iAmArsta/Propeller-v-thrust/README.md

# Propeller-v-thrust
The setup for my IB Physics IA, investigating the effect of propeller blade pitch on thrust.
Code and 3d files have been uploaded.

Parts list:
ESP32 doit devkit
5kg load cell
HX711 module
Any infrared sensor
1400kv 2212 brushless motor
30 Amp ESC
