iAmArsta/Propeller-v-thrust/STLs/physicProjmotorMount_PLA_25m55s.stl

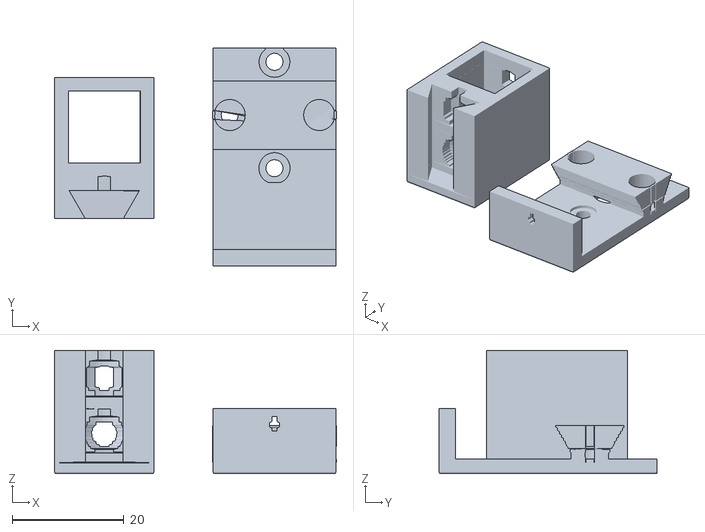
[picture p7: CAD file, 2026-11-01]
STLs/physicProjmotorMount_PLA_25m55s.stl
50.4 x 39.0 x 22.0
