iAmArsta/Propeller-v-thrust/STLs/Prop_130mm_10deg_v2_PETG_1h52m.stl

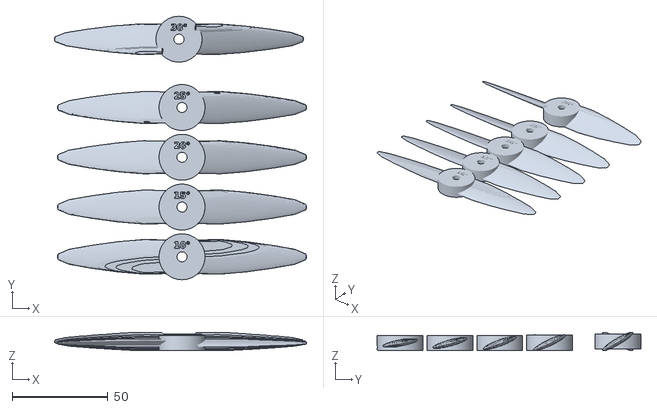
[picture p8: CAD file, 2026-11-01]
STLs/Prop_130mm_10deg_v2_PETG_1h52m.stl
131.6 x 137.7 x 9.60
