iAmArsta/Propeller-v-thrust/STLs/physProj_PLA_1h11m.stl

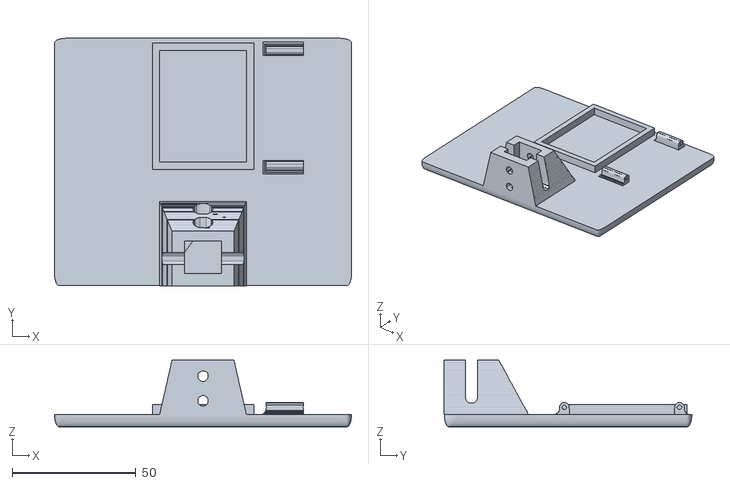
[picture p9: CAD file, 2026-11-01]
STLs/physProj_PLA_1h11m.stl
119.9 x 99.9 x 27.0
