iAmArsta/Propeller-v-thrust/STLs/physicProjmotorMount13_PLA_15m30s.stl

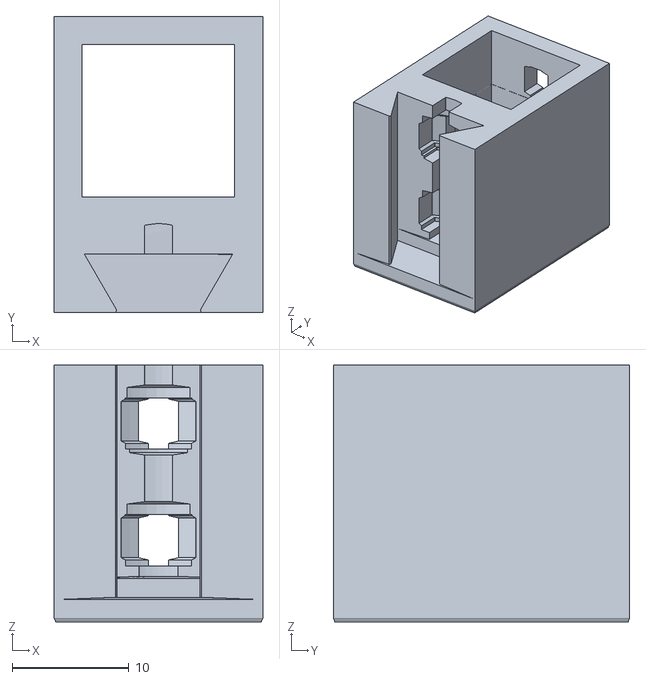
[picture p10: CAD file, 2026-11-01]
STLs/physicProjmotorMount13_PLA_15m30s.stl
17.9 x 25.4 x 22.0
