iAmArsta/Propeller-v-thrust/STLs/physicProjmotorMount13.4_PLA_15m22s.stl

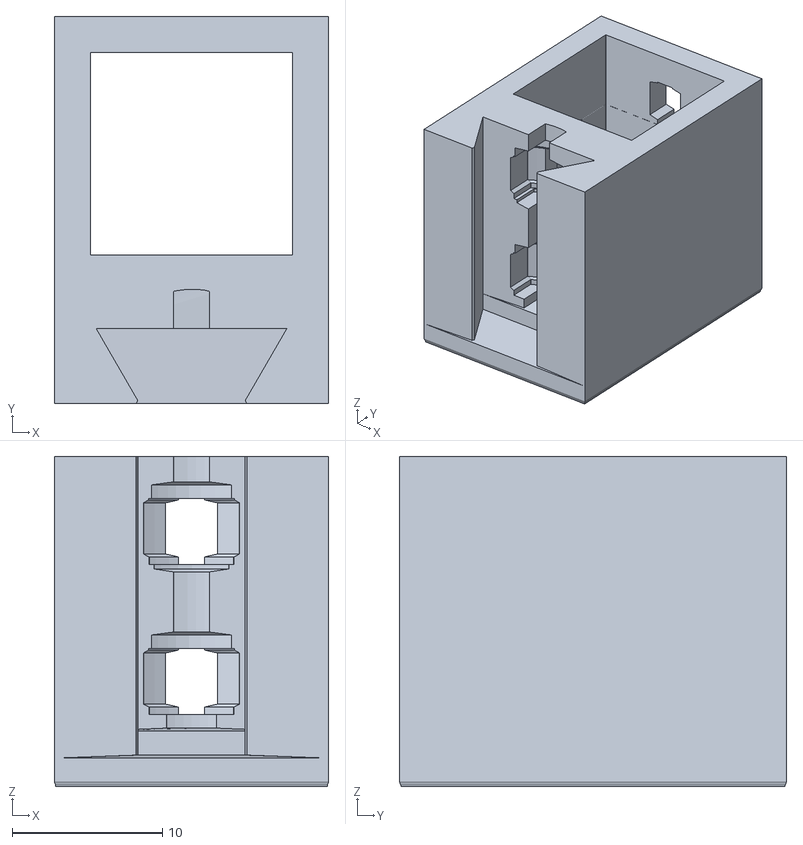
[picture p11: CAD file, 2026-11-01]
STLs/physicProjmotorMount13.4_PLA_15m22s.stl
18.3 x 25.8 x 22.0
