iAmArsta/Propeller-v-thrust/STLs/physicProjmotorMount_PLA_15m24s.stl

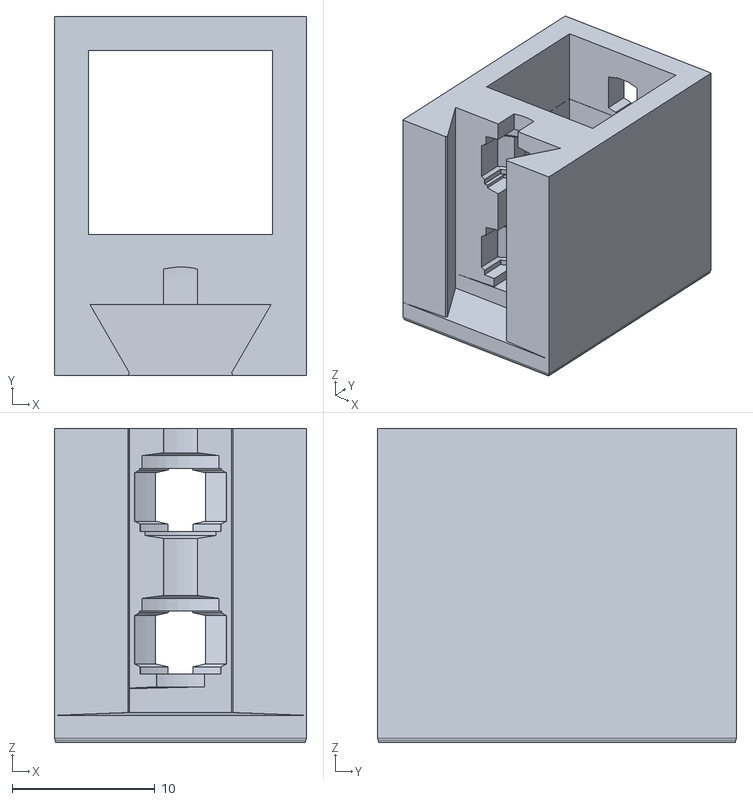
[picture p12: CAD file, 2026-11-01]
STLs/physicProjmotorMount_PLA_15m24s.stl
17.7 x 25.2 x 22.0
