iAmArsta/Propeller-v-thrust/STLs/Prop_130mm_30deg_v2.stl

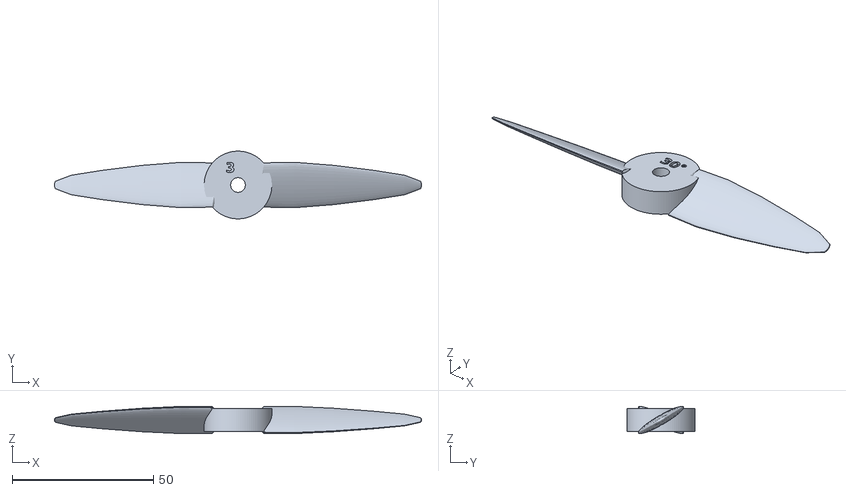
[picture p13: CAD file, 2026-11-01]
STLs/Prop_130mm_30deg_v2.stl
130.1 x 24.0 x 9.66
