iAmArsta/Propeller-v-thrust/STLs/Prop_130mm_55deg_v3.stl

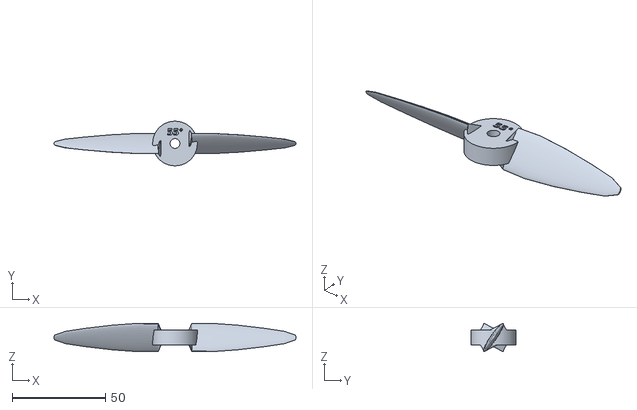
[picture p15: CAD file, 2026-11-01]
STLs/Prop_130mm_55deg_v3.stl
130.1 x 24.0 x 15.3
