iAmArsta/Propeller-v-thrust/STLs/Prop_130mm_35deg_v3.stl

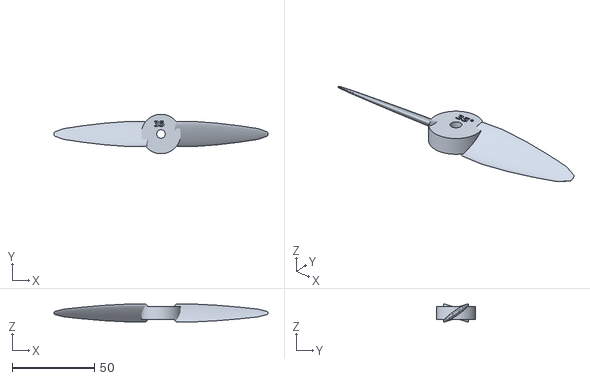
[picture p16: CAD file, 2026-11-01]
STLs/Prop_130mm_35deg_v3.stl
130.1 x 24.0 x 10.9
