iAmArsta/Propeller-v-thrust/(list of files, cad)

Other CAD files:
STLs/Prop_130mm_10deg_v2.stl
STLs/Prop_130mm_15deg_v2.stl
